lperovich/artBoat/README.md

# ArtBoat

Laura Perovich (perovich@media.mit.edu, www.lauraperovich.com) 
Object-based Media, MIT Media Lab

Code, hardware, and fabrication guides for ArtBoat, a community centered public art tool for light painting. A SeeBoat companion project.

LoRA radio (Adafruit Feather) communication with LED strip output.
