lperovich/artBoat/hardware/artBoat_fullPartsList.xlsx

Sheet: final
Parts list for ArtBoat, the light painting companion to SeeBoat
by Laura Perovich
2018-06-01
BOAT
item | part number | place | description | number | cost/item | link
Blackjack 24" Brushless Catamaran RTR | PRB08007 | Horizon Hobby | the full boat, including radio controller | 1 | $230 | https://www.horizonhobby.com/blackjack-24-inch-catamaran-brushless%3A-rtr-prb08007
LiPo battery Reaction 7.4V 5000mAh 2S 30C LiPo Hardcase: EC3 |  | Horizon Hobby | large battery for the boat | 1 | $50 | https://www.horizonhobby.com/74v-5000mah-2s-30c-lipo-hardcase%3A-ec3-dyn9005ec
Krylon K02421007 Fusion for Plastic Spray Paint, Satin Black |  | Amazon | to paint the boat so it blends into the background better at night | 1 | $7 | https://www.amazon.com/gp/product/B000C0158E/
isopropyl alcohol |  | Amazon | to remove stickers from boat and clean boat | 1 | $8 | https://www.amazon.com/Isopropyl-Alcohol-Solution-16-Ounce/dp/B000P158X8?th=1
AA batteries |  | Amazon | for radio controllers | 3 | $15 | https://www.amazon.com/Duracell-MN1500-Duralock-Alkaline-Batteries/dp/B003VSCLMI/
painters tape |  | Amazon | to paint the boat so it blends into the background better at night | 1 | $10 | https://www.amazon.com/STIKK-Painters-Release-Finishing-Masking/dp/B01MYP8R5B
600-800 grit sandpaper |  | Amazon | to prep the boat for painting | 1 | $7 | https://www.amazon.com/INDUSTRIES-4471-Sandpaper-9-Inch-11-Inch/dp/B001AVYXVU
HobbyKing 350w 25A Power Supply (100v~120v) |  | Hobby King | liPo battery charger | 1 | $46 | https://hobbyking.com/en_us/hobbyking-350w-25a-power-supply-100v-120v.html
iCharger 208B 350W 8s Balance/Charger |  | Hobby King | liPo battery charger | 1 | $126 | https://hobbyking.com/en_us/icharger-206b-300w-8s-balance-charger.html
Stealthwake 23" Brushed Deep-V RTR |  | Horizon Hobby | alternative cheaper boat that may also work--test this | 1 | $160 | https://www.horizonhobby.com/boats/electric-boats/stealthwake-rtr-23-inch-brushed-deep-v-prb08015
LIGHT CONTROL BOARD (on land)
item | part number | place | description | number | cost/item | link
Adafruit feather M0 LoRa RMF95 900MHz |  | Adafruit | main radio board | 1 | $35 | https://www.adafruit.com/product/3178
male headers |  | Adafruit | for top board | 1 | $3.00 | https://www.adafruit.com/product/392
feather female headers |  | Adafruit | for feather board | 4 | $1.00 | https://www.adafruit.com/product/2886
micro USB cable |  | Amazon | cable for programming feather | 1 | $5.59 | https://www.amazon.com/gp/product/B00NH13O7K
liPo battery 2500mAh mAh 3.7V |  | Adafruit | substantial enough to work with LED strip (https://learn.adafruit.com/lightship-led-animation-over-wifi/hardware circuit 1) | 1 | $15 | https://www.adafruit.com/product/328
custom color control board |  | OSH park | allows you to select and save colors | 1 | $35 | see GitHub hardware folder
plywood 1/8" x 12" x12" |  | Blick | longer would be better | 1 | $4
screws 4x40, 3/8" |  | Pill's Hardware | for attaching casing together, board parts to board | 8 | $0.15
screws 4x40, 5/8" |  | Pill's Hardware | for attaching casing together, corners | 4 | $0.15
nuts 4x40 |  | Pill's Hardware | for attaching casing together | 12 | $0.20
nylon spacers 1/4" height |  | Tag Hardware | for keeping the correct distance between the PCB and the casing | 4 | $0.20
pot slider 10K 45MM | PTA4543-2010CIB103-ND | Digikey | to control RGB balance | 3 | $1.50 | https://www.digikey.com/products/en?keywords=PTA4543-2010CIB103-ND
slider knob | 1722-1330-ND | Digikey | goes with sliders | 3 | $1.39 | https://www.digikey.com/products/en?keywords=1722-1330-ND
Button Pad 2x2 - LED Compatible |  | Sparkfun | to save or select colors | 3 | $3 | https://www.sparkfun.com/products/7836
DotStar Addressable 5050 RGB LED w/ Integrated Driver - 10 Pack |  | Adafruit | lights under soft buttons | 2 | $5 | https://www.adafruit.com/product/2343
slide switch DPDT 100MA 12V | 563-1025-ND | Digikey | on/off switch | 1 | $2.50 | https://www.digikey.com/product-detail/en/nidec-copal-electronics/CRFS-2202W/563-1025-ND/948336
rotary potentiometer 1K carbon linear | PTV09A-4225F-B102-ND | Digikey | to control fade speed | 1 | $0.83 | https://www.digikey.com/products/en?keywords=PTV09A-4225F-B102-ND
FAB class diode | 641-1331-1-ND | Digikey | for button presses | 18 | $0.19 | https://www.digikey.com/products/en?keywords=641-1331-1-ND
SMD resistor 0603 4.7K | RMCF0603FT4K70CT-ND | Digikey | for button pins | 5 | $0.10 | https://www.digikey.com/product-detail/en/stackpole-electronics-inc/RMCF0603FT4K70/RMCF0603FT4K70CT-ND/1943033
SMD capacitor; 0603, 4.7 uF | 399-5089-1-ND | Digikey | for smoothing out the potentiometers | 3 | $0.30 | https://www.digikey.com/product-detail/en/kemet/C0603C104K5RACTU/399-5089-1-ND/1465623
LIGHTS BOARD (on boat)
item | part number | place | description | number | cost/item | link
Adafruit DotStar Digital LED Strip - White 60 LED - Per Meter - WHITE |  | Adafruit | 5V plays nice with the feather | 1 | $30 | https://www.adafruit.com/product/2240
silicon clear adhesive for water applications |  | Tag Hardware | to glue acrylic strips to boat | 1 | $8.00
1/8" satin ice white acrylic strips (~2"x17" per strip, purchase strips as a block) |  | Tap Plastics | testing using acrylic (with epoxy casting?) to display lights through holes cut into the boat to replace the dragonskin silcon encased LED strip on the outside of the boat | 1 | $10 | https://www.tapplastics.com/product/plastics/cut_to_size_plastic/satinice_white/655
liPo battery 2500mAh mAh 3.7V |  | Adafruit | substantial enough to work with LED strip (https://learn.adafruit.com/lightship-led-animation-over-wifi/hardware circuit 1) | 1 | $15 | https://www.adafruit.com/product/328
Adafruit feather M0 LoRa RMF95 900MHz |  | Adafruit | main radio board | 1 | $35 | https://www.adafruit.com/product/3178
male headers |  | Adafruit | for top board | 1 | $3.00 | https://www.adafruit.com/product/392
feather female headers |  | Adafruit | for feather board | 4 | $1.00 | https://www.adafruit.com/product/2886
custom breakout board |  | OSH Park | connects to all sensors--only use lighstrand connector for artBoat | 1 | $5 | see SeeBoat Github hardware folder, controlBoard-0.5
resistor SMD 0603 2.7K | RNCP0603FTD2K74CT-ND | Digikey | for I2C--exact value is important!! | 2 | $0.10 | https://www.digikey.com/products/en?keywords=RNCP0603FTD2K74CT-ND
DPDT switch SMD | 401-2013-1-ND | Digikey | turns the board on/off | 1 | $1.07 | https://www.digikey.com/product-detail/en/AYZ0202AGRLC/401-2013-1-ND/1640122
4-pin header female Molex, LLC 0705430003 | WM4802-ND | Digikey | connects out to LED strip (female, on board) | 4 | $0.94 | https://www.digikey.com/products/en?keywords=WM4802-ND
4-pin header male Molex Connector Corporation 0014562042 | WM9131-ND | Digikey | connects out to LED strip (male, on wire) | 4 | $1.46 | https://www.digikey.com/products/en?keywords=WM9131-ND
flat ribbon cable 3M 3302/16 300SF | MC16M-100-ND | Digikey | connects out to sensors and lights | 1 | $95.15 | https://www.digikey.com/product-detail/en/3m/3302-16-300SF/MC16M-100-ND/145737 | verify this is the right answer

Sheet: archiveParts
item | part number | place | description | number | cost/item | link
dragon skin 30 |  | Amazon | for opaque LED strip | 1 | $31 | https://www.amazon.com/dp/B00EOA0EC6/ref=cm_sw_r_cp_api_xzDjAbNHV1FRW
powdered sugar |  | grocery store | to make the LEDs diffuse more through the silicon | 1 | $8 | https://www.amazon.com/Domino-Powdered-Confectioners-Sugar-16oz/dp/B0019N2EQU
waterproof adhesive |  | Amazon | for sealing the holes the LED wires go through and attaching LEDs to boat; other options could work | 1 | $27 | https://www.amazon.com/gp/product/B000H83M4G/
acrylic (1/8", 12"x24") |  | Amazon | for making a box to use for casting the LEDs in silicon | 1 | $25 | https://www.amazon.com/Source-One-LLC-Acrylic-Plexiglass/dp/B01FEF0VQI/
white polyester transparent fabric |  | local fabric store | to put in silicon to diffuse the LED strip more | 1 | $5
aluminum tape for reflecting |  | Amazon | backing for LED strip to maximize light out--test this | 1 | $10 | https://www.amazon.com/Aluminum-Tape-Foil-Ducts-Insulation/dp/B01FROBUXE/
