lperovich/artBoat/hardware/boatColorControlBiggerButtonV4/boatColorControlBiggerButtonV4.brd

## EAGLE design hardware/boatColorControlBiggerButtonV4/boatColorControlBiggerButtonV4.brd (2018-06-27)

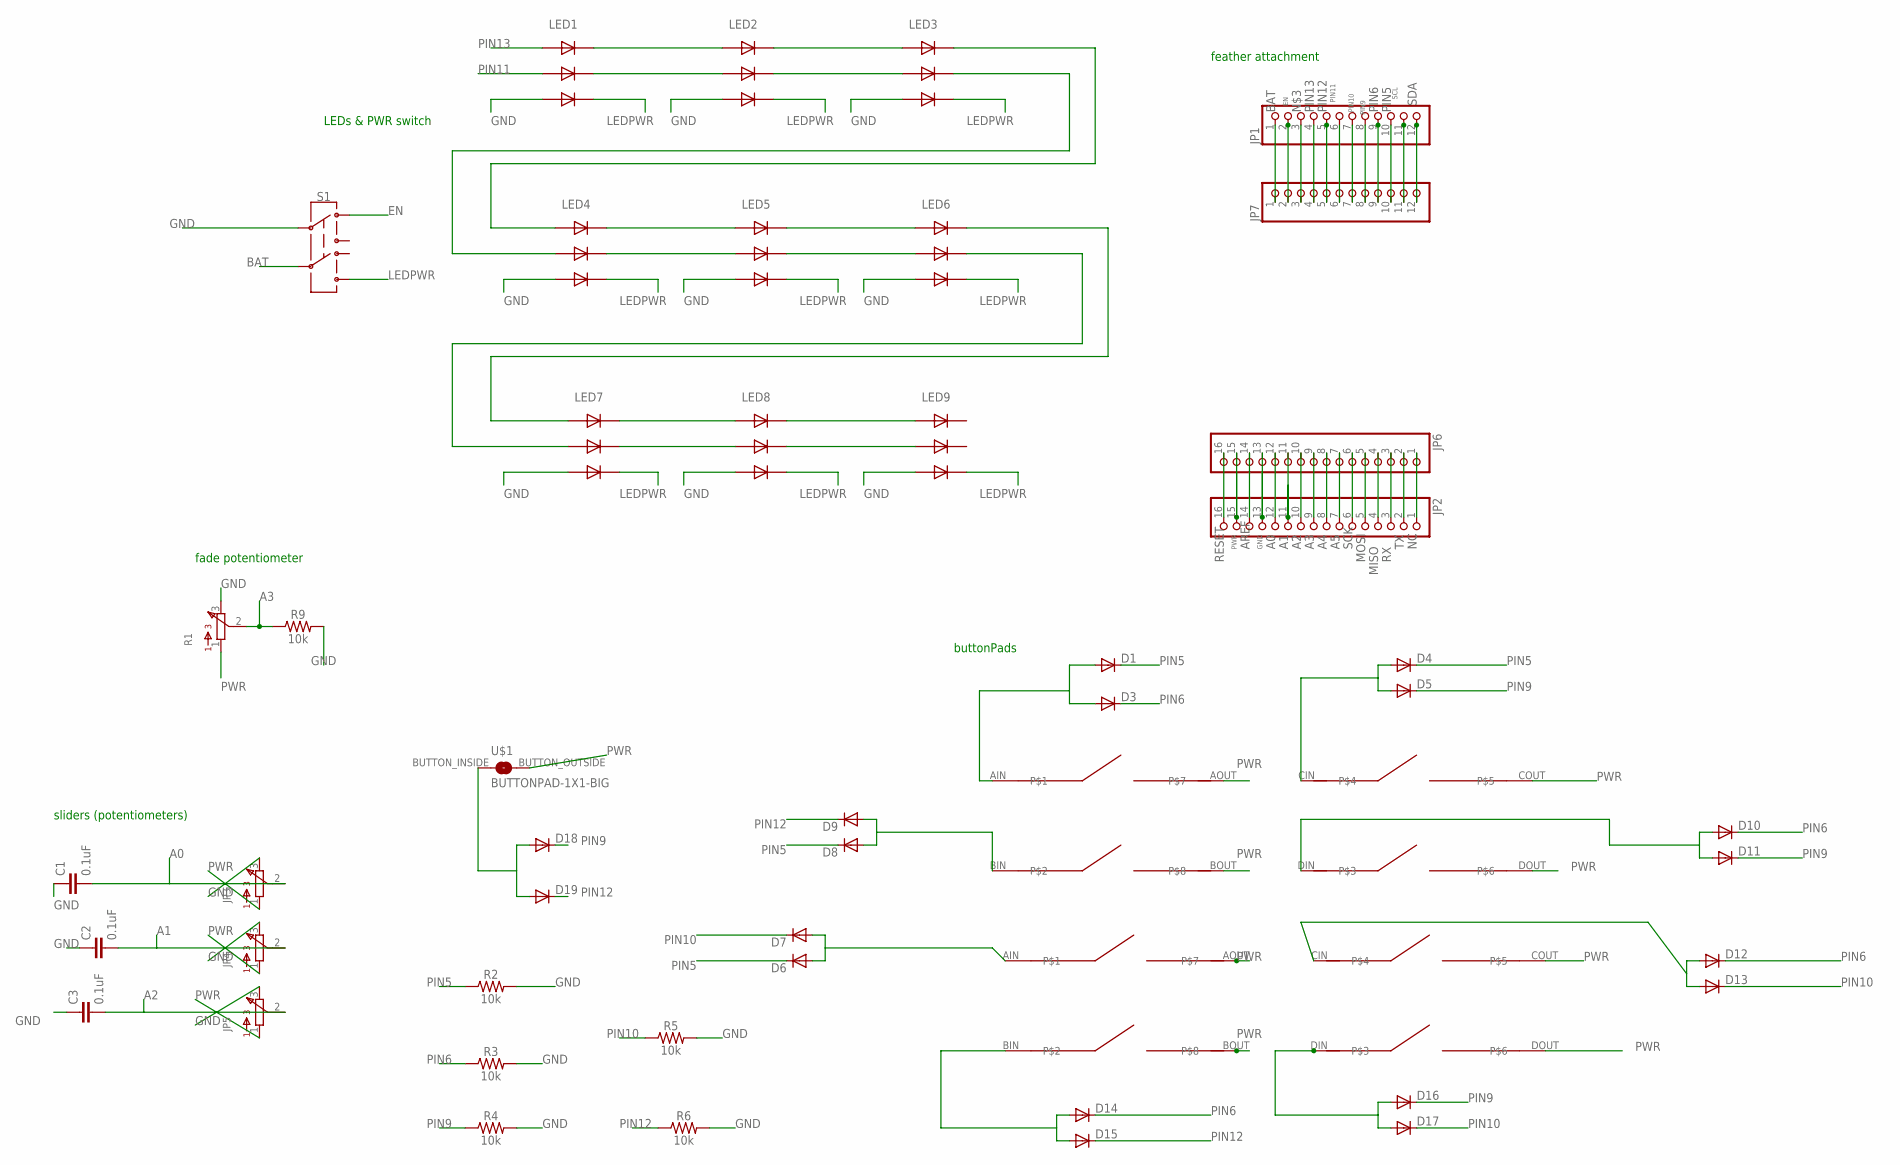
[picture p1: schematic boatColorControlBiggerButtonV4.sch]

Parts:
C1, C2, C3: 0.1uF; 0603
D1, D3, D4, D5, D6, D7, D8, D9, D10, D11, D12, D13, D14, D15, D16, D17, D18, D19: DIODESOD123; SOD123
JP1, JP7: PINHD-1X12; 1X12
JP2, JP6: PINHD-1X16; 1X16
JP3, JP4, JP5: BOURNESPOTENTIOMETER
LED1, LED2, LED3, LED4, LED5, LED6, LED7, LED8, LED9: RGBLED_DOTSTAR5050; RGBLED5050_DOTSTAR
R1: PTV_BOURNES_POT; PVT_BOURNES_POT
R2, R3, R4, R5, R6, R9: 10k; 0603
S1: SWITCH-DPDT-PTH-GPI-152-3013; SWITCH_DPDT_CRFS-2202W
U$1: BUTTONPAD-1X1-BIG; BUTTONPAD-1X1
U$9, U$13: BUTTONPAD2X2; BUTTONPAD-2X2

Connections:
A0: C1.2, JP2.12, JP3.2, JP6.12
A1: C2.2, JP2.11, JP4.2, JP6.11
A2: C3.2, JP2.10, JP5.2, JP6.10
A3: JP2.9, JP6.9, R1.2, R9.1
A4: JP2.8, JP6.8
A5: JP2.7, JP6.7
AREF: JP2.14, JP6.14
BAT: JP1.1, JP7.1, S1.C@2 (5)
EN: JP1.2, JP7.2, S1.10 (1)
GND: C1.1, C2.1, C3.1, JP2.13, JP3.3, JP4.3, JP5.3, JP6.13, LED1.GND, LED2.GND, LED3.GND, LED4.GND, LED5.GND, LED6.GND, LED7.GND, LED8.GND, LED9.GND, R1.3, R2.2, R3.2, R4.2, R5.2, R6.2, R9.2, S1.C@1 (2)
LEDPWR: LED1.VCC, LED2.VCC, LED3.VCC, LED4.VCC, LED5.VCC, LED6.VCC, LED7.VCC, LED8.VCC, LED9.VCC, S1.21 (6)
MISO: JP2.4, JP6.4
MOSI: JP2.5, JP6.5
unnamed: JP1.3, JP7.3
unnamed: LED1.DATAOUT, LED2.DATAIN
unnamed: LED1.CLOCKOUT, LED2.CLOCKIN
unnamed: LED2.DATAOUT, LED3.DATAIN
unnamed: LED2.CLOCKOUT, LED3.CLOCKIN
unnamed: LED4.DATAOUT, LED5.DATAIN
unnamed: LED4.CLOCKOUT, LED5.CLOCKIN
unnamed: LED5.DATAOUT, LED6.DATAIN
unnamed: LED5.CLOCKOUT, LED6.CLOCKIN
unnamed: LED7.DATAOUT, LED8.DATAIN
unnamed: LED7.CLOCKOUT, LED8.CLOCKIN
unnamed: LED8.DATAOUT, LED9.DATAIN
unnamed: LED8.CLOCKOUT, LED9.CLOCKIN
unnamed: LED3.CLOCKOUT, LED4.CLOCKIN
unnamed: LED3.DATAOUT, LED4.DATAIN
unnamed: LED6.DATAOUT, LED7.DATAIN
unnamed: LED6.CLOCKOUT, LED7.CLOCKIN
unnamed: D1.ANODE (A), D3.ANODE (A), U$9.AIN
unnamed: D4.ANODE (A), D5.ANODE (A), U$9.CIN
unnamed: D6.ANODE (A), D7.ANODE (A), U$13.AIN
unnamed: D8.ANODE (A), D9.ANODE (A), U$9.BIN
unnamed: D10.ANODE (A), D11.ANODE (A), U$9.DIN
unnamed: D12.ANODE (A), D13.ANODE (A), U$13.CIN
unnamed: D14.ANODE (A), D15.ANODE (A), U$13.BIN
unnamed: D16.ANODE (A), D17.ANODE (A), U$13.DIN
unnamed: D18.ANODE (A), D19.ANODE (A), U$1.BUTTON_INSIDE (BUTTONINSIDE)
NC: JP2.1, JP6.1
PIN5: D1.CATHODE (C), D4.CATHODE (C), D6.CATHODE (C), D8.CATHODE (C), JP1.10, JP7.10, R2.1
PIN6: D3.CATHODE (C), D10.CATHODE (C), D12.CATHODE (C), D14.CATHODE (C), JP1.9, JP7.9, R3.1
PIN9: D5.CATHODE (C), D11.CATHODE (C), D16.CATHODE (C), D18.CATHODE (C), JP1.8, JP7.8, R4.1
PIN10: D7.CATHODE (C), D13.CATHODE (C), D17.CATHODE (C), JP1.7, JP7.7, R5.1
PIN11: JP1.6, JP7.6, LED1.CLOCKIN
PIN12: D9.CATHODE (C), D15.CATHODE (C), D19.CATHODE (C), JP1.5, JP7.5, R6.1
PIN13: JP1.4, JP7.4, LED1.DATAIN
PWR: JP2.15, JP3.1, JP4.1, JP5.1, JP6.15, R1.1, U$1.BUTTON_OUTSIDE (BUTTONOUTSIDE), U$9.AOUT, U$9.BOUT, U$9.COUT, U$9.DOUT, U$13.AOUT, U$13.BOUT, U$13.COUT, U$13.DOUT
RESET: JP2.16, JP6.16
RX: JP2.3, JP6.3
SCK: JP2.6, JP6.6
SCL: JP1.11, JP7.11
SDA: JP1.12, JP7.12
TX: JP2.2, JP6.2

Notes on the sheet:
LEDs & PWR switch
buttonPads
sliders (potentiometers)
feather attachment
fade potentiometer

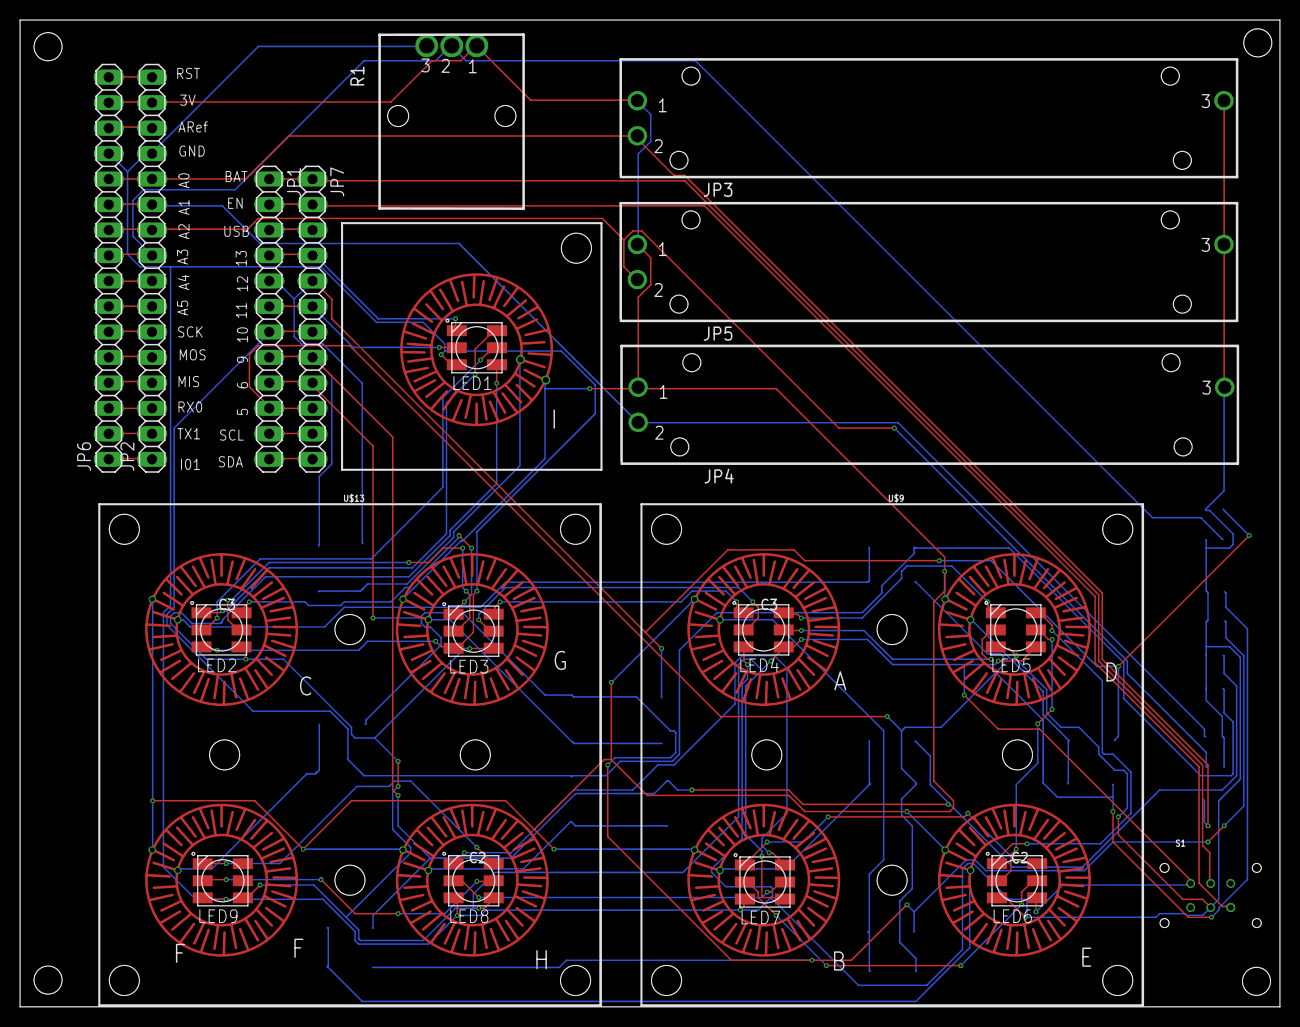
[picture p2: board boatColorControlBiggerButtonV4.brd from above]

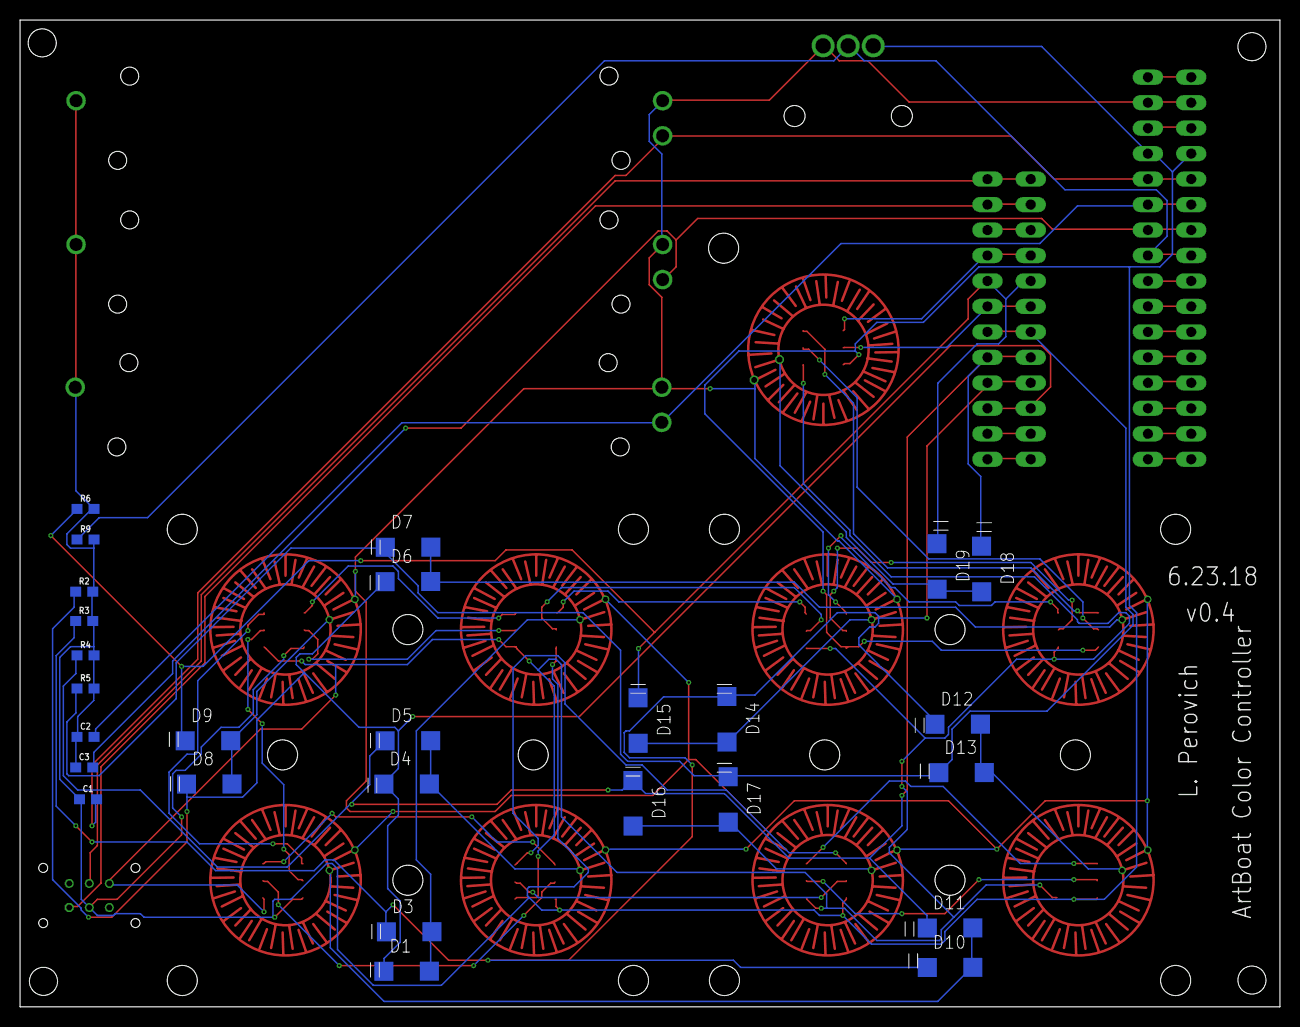
[picture p3: board boatColorControlBiggerButtonV4.brd from below]

Board: 2 copper layers, 125.7 x 98.4 mm, 48 parts (27 on the bottom side), 54 nets.
