lperovich/artBoat/(commit log)

2018-06-26 software update
    [artBoat_fullPartsList.xlsx]
2018-06-27 hardware update
    [boatColorControlBiggerButtonV4.brd]
2018-07-24 update parts lists w/header
    [artBoat_fullPartsList.xlsx]
